mattyicebox/ECE445_Towfish_Magnetometer/CAD_Files/SP26_HookLineandTowfish_AutoDeskInventorFiles_JamesBrasfield/readme.md

M4 heatsink inserts and screws are used for securing the back cap on. M3 screws are used for attaching the PCB to the insert.
