mattyicebox/ECE445_Towfish_Magnetometer/Hardware_Specs/hardware.txt

This file contains the PCB and schematic PDF's from our design.
