mattyicebox/ECE445_Towfish_Magnetometer/(list of files, cad)

Other CAD files:
CAD_Files/AssemblyV1.dwg
CAD_Files/AssemblyV1.iam
CAD_Files/BackCapV1.ipt
CAD_Files/BackCapV2.ipt
CAD_Files/BackInsertV1.ipt
CAD_Files/BackTubeV1.ipt
CAD_Files/BottleV1.ipt
CAD_Files/CoilV1.ipt
CAD_Files/FrontBumper.ipt
CAD_Files/FrontCapV1.ipt
CAD_Files/FrontTubeV1.ipt
CAD_Files/InsertV1.ipt
CAD_Files/OringV1.ipt
CAD_Files/OringV2.ipt
CAD_Files/PCBV1.ipt
