mattyicebox/ECE445_Towfish_Magnetometer/CAD_Files/AssemblyV1.png

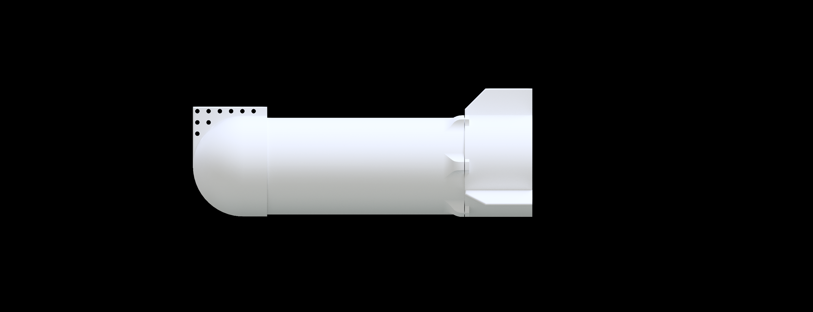
CAD_Files/AssemblyV1.png
