mattyicebox/ECE445_Towfish_Magnetometer/Hardware_Specs/SP26_HookLineandTowfish_description_JamesBrasfieldandBlakeHelland.pdf

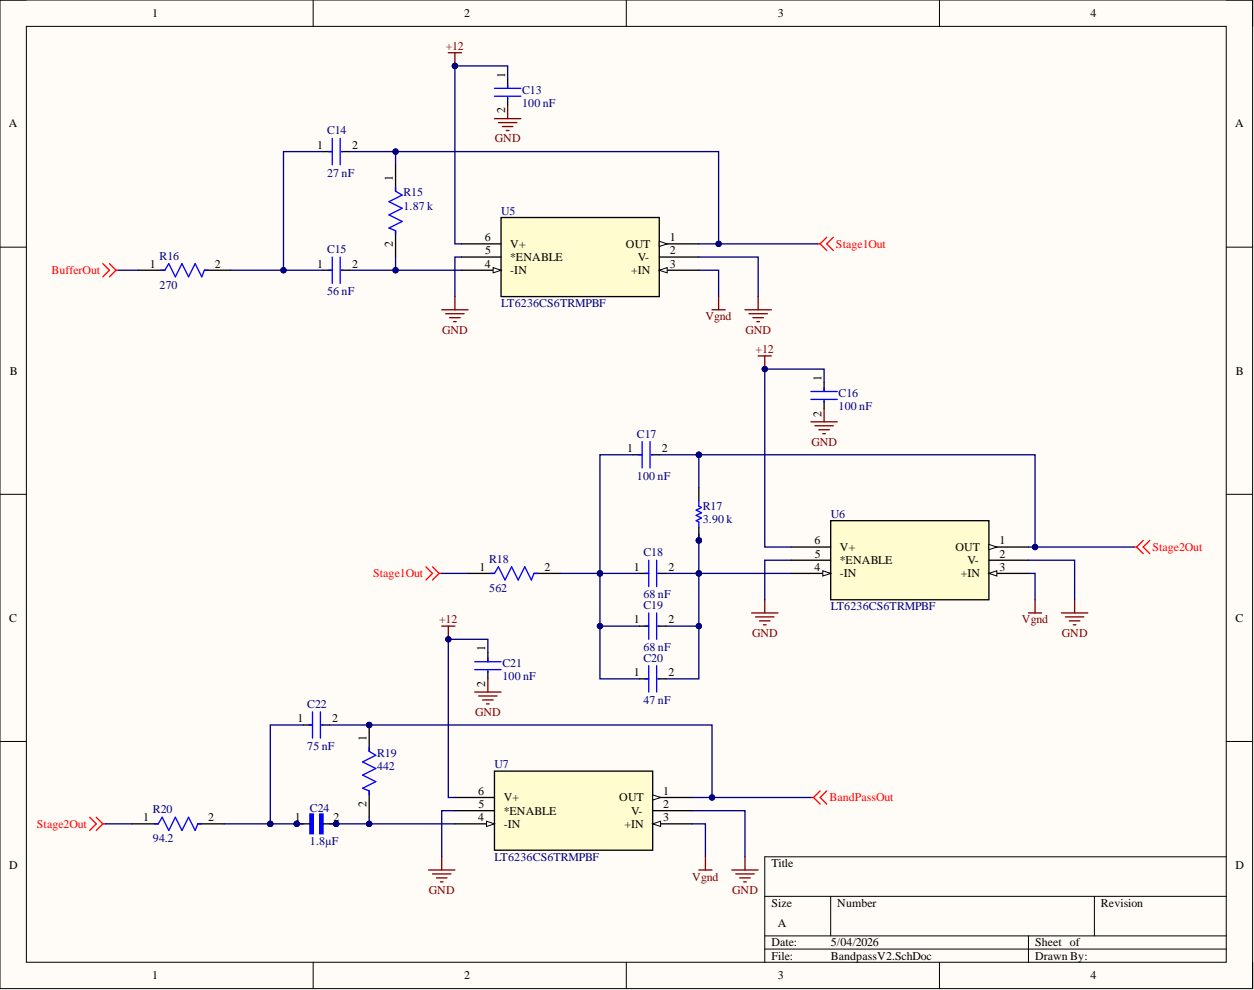
[picture p2: page 1]

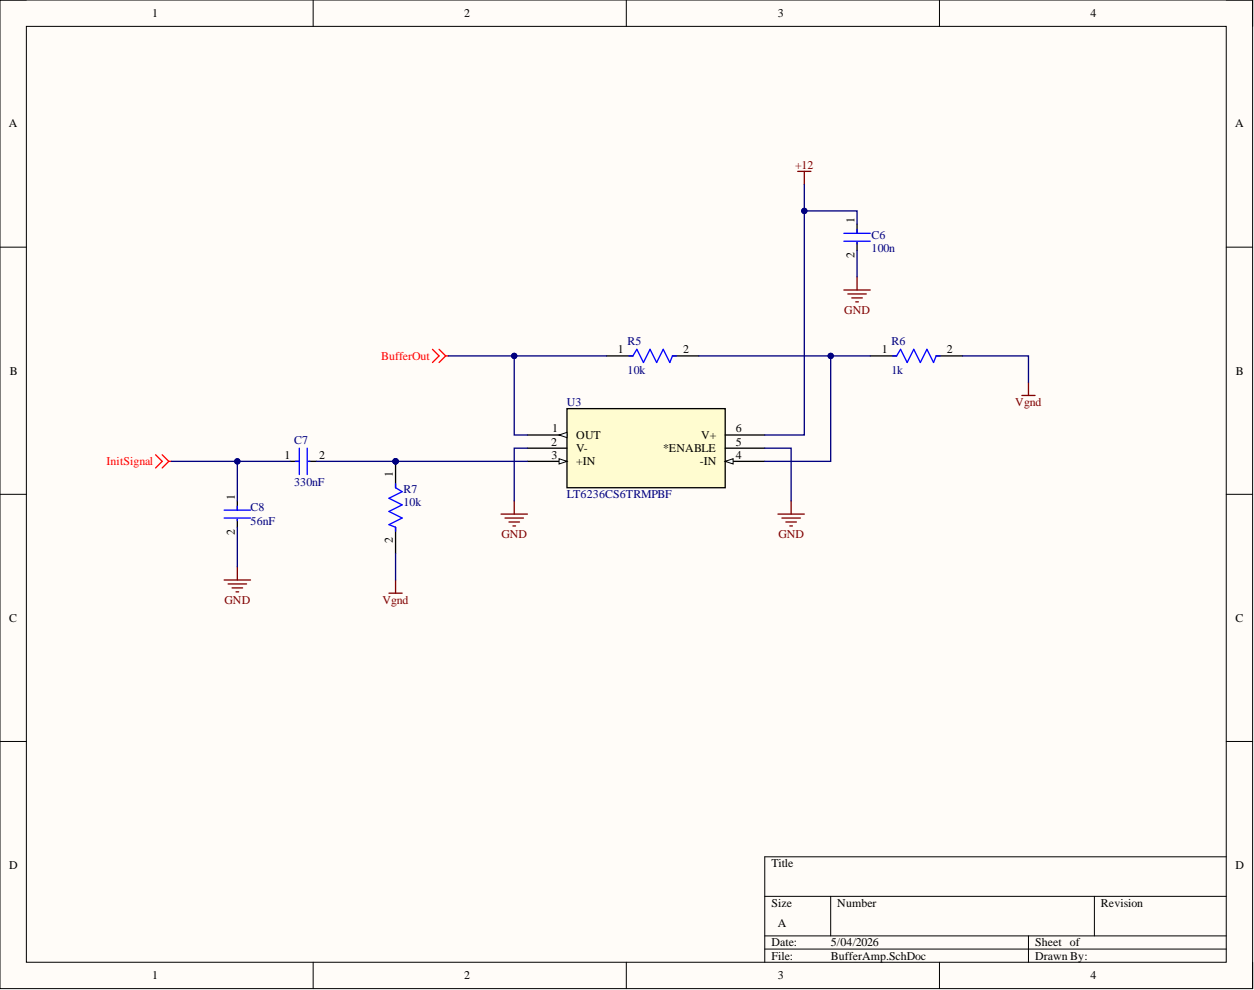
[picture p3: page 2]
File:; BufferAmp.SchDoc; Drawn By:; OUT 1 V- 2; 4 *ENABLE; InitSignal

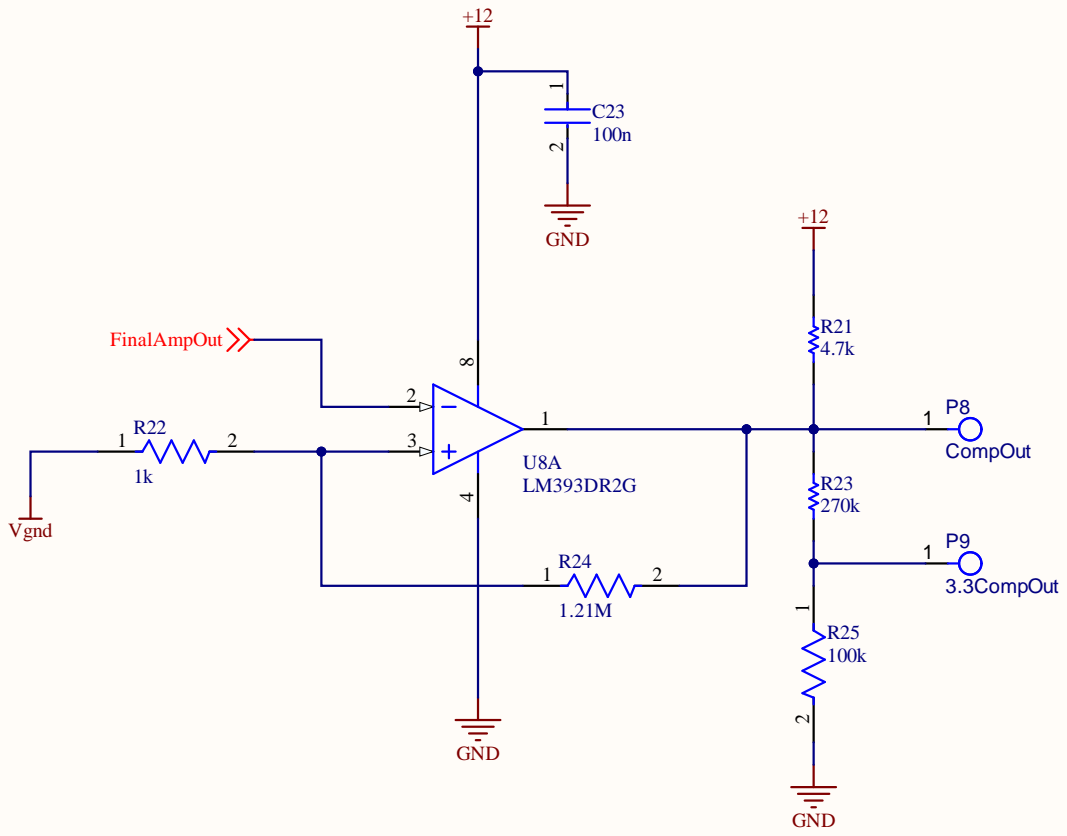
[picture p4: page 3]
1 P8CompO

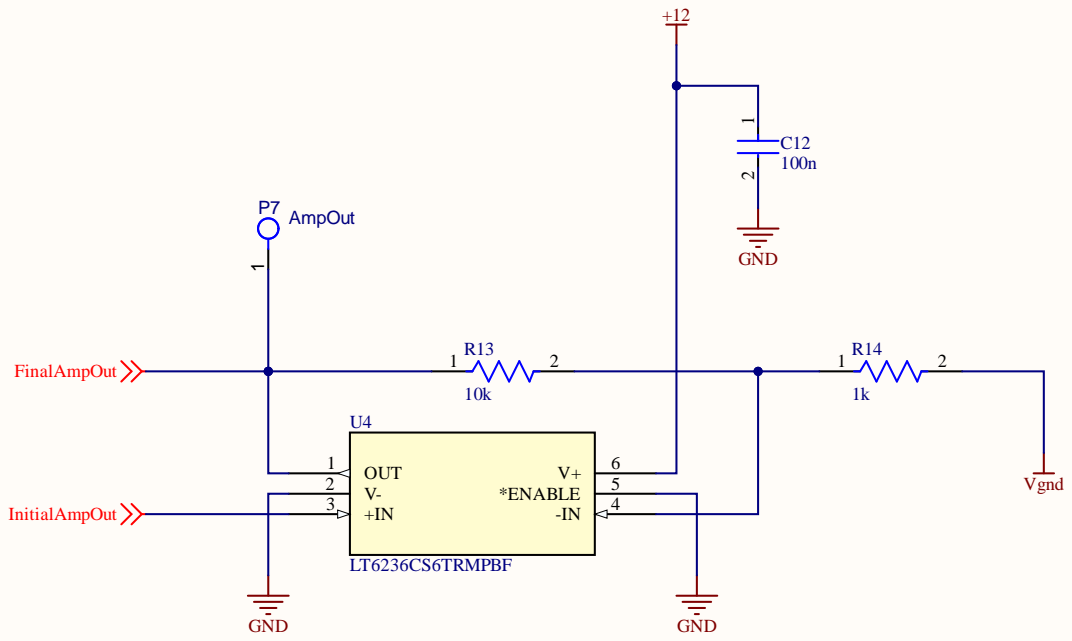
[picture p5: page 4]
File:; FinalAmp.SchDoc; Drawn By:; OUT 1 V- 2; 4 *ENABLE; 1 P7 AmpOut

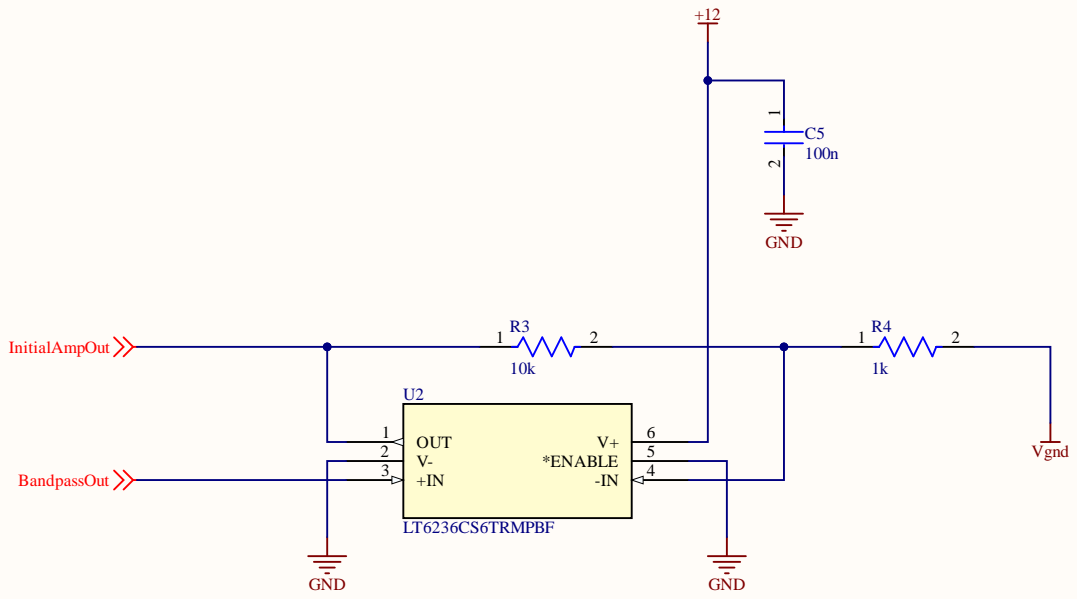
[picture p6: page 5]
File:; InitialAmp.SchDoc; Drawn By:; OUT 1 V- 2; 4 *ENABLE

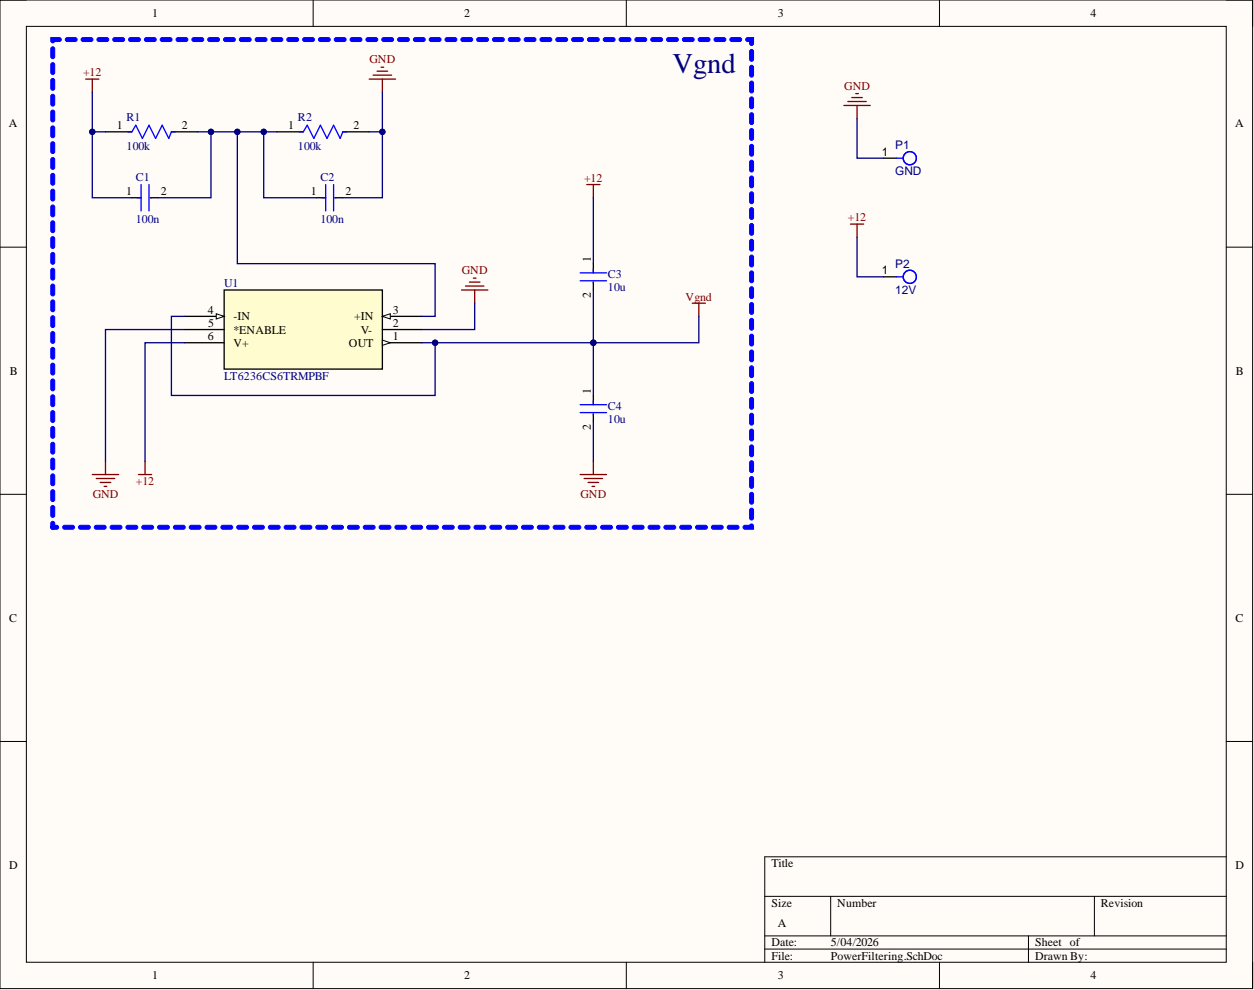
[picture p7: page 6]

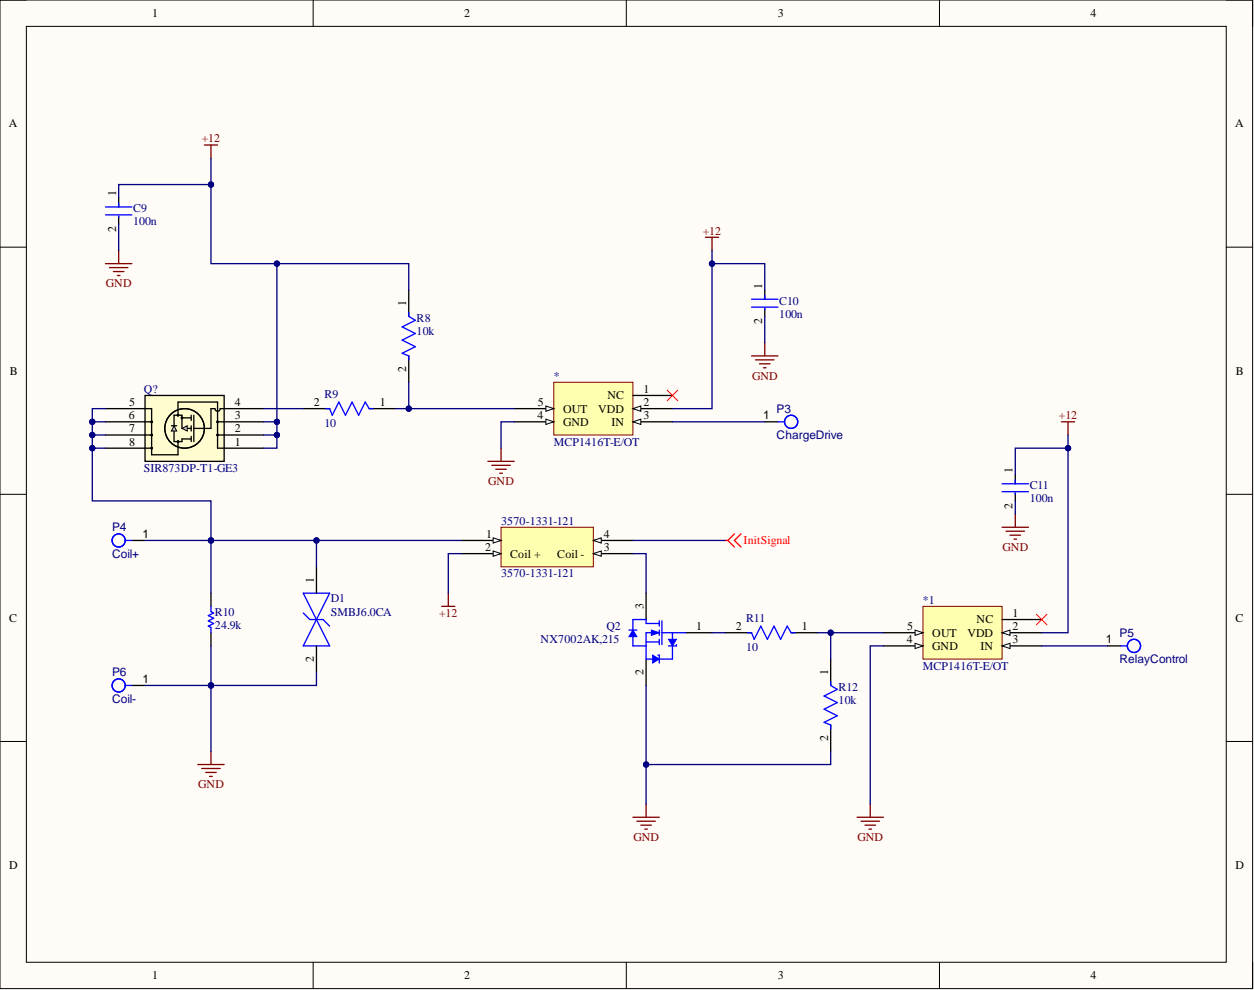
[picture p8: page 7]
