mattyicebox/ECE445_Towfish_Magnetometer/CAD_Files/AssemblyV1.pdf

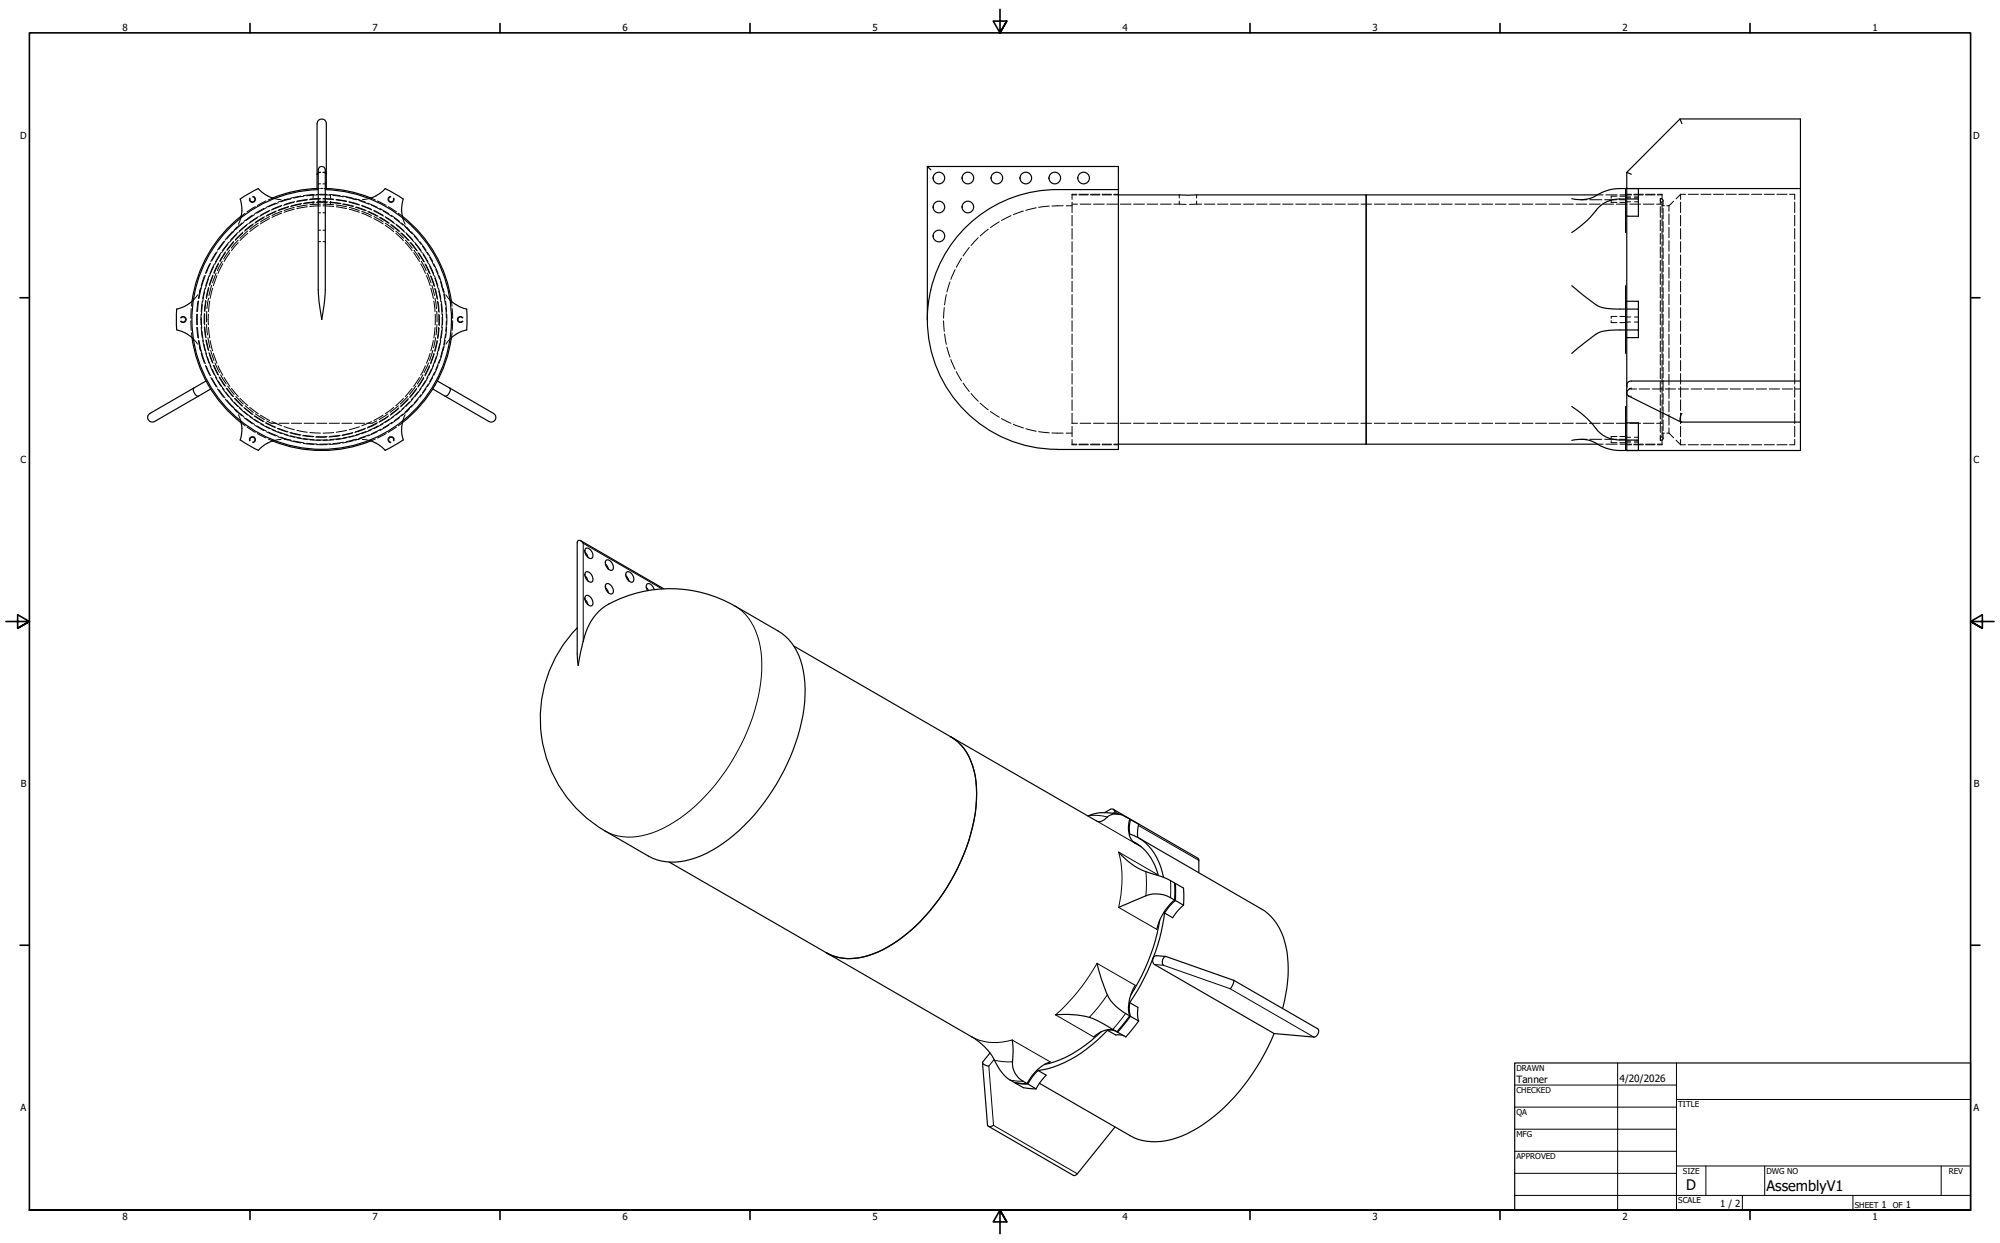
[picture p9: page 1]

DRAWN Tanner | 4/20/2026

CHECKED

MFG

APPROVED

SIZE D | DWG NO AssemblyV1 | REV

SCALE 1 / 2 | | SHEET 1 OF 1
