mattyicebox/ECE445_Towfish_Magnetometer/Simulations/DCOffsetTestV1.asc

C1: cap; 1µ
R1: res; 200
R2: res; 20k
U1: UniversalOpAmp; Avol=100k GBW=10Meg Vos=0
V1: voltage; SINE(0 3u 3k)
V2: voltage; 6
V4: voltage; 12
Named nets: 0, Vout, Vin+6, Vin
.tran 0 0.0005 0 0.000000001
