mattyicebox/ECE445_Towfish_Magnetometer/Simulations/SP26_HookLineandTowfish_BufferOffsetSimulation_JamesBrasfield.asc

C1: cap; 1ľ
C2: cap; 56n
R1: res; 10k
R2: res; 1k
R3: res; 10k
U1: UniversalOpAmp
V1: voltage; 6
V2: voltage; SINE(0 3m 200)
V3: voltage; 6
V4: voltage; 12
Named nets: 0, Vout, Vin+6
.tran 0 0.01 0 0.0000001
