mattyicebox/ECE445_Towfish_Magnetometer/Simulations/SP26_HookLineandTowfish_SwitchingSimulation_JamesBrasfield.asc

D1: zener
D2: zener
L1: ind2; 17m; Rser=9
L2: ind2; 17m; Rser=9
M1: pmos
M2: nmos
M3: nmos
R1: res; 10
R2: res; 10k
R3: res; 10
R4: res; 10k
R5: res; 25k
V1: voltage; 12
V2: voltage; PULSE(12 0 1m 200n 200n 20m 50m)
V3: voltage; 0
Named nets: 0, Inductor, PMOS
.model D D(BV=68 IBV=1m RS=0.2 N=1.2 CJO=200p)
; ===== Gate timing (long charge, long discharge) =====
; V2 drives PMOS gate: OFF = 12V, ON = 0V
; ON from 1ms to 21ms (20ms charge window), then OFF
V2 GP 0 PULSE(12 0 1m 200n 200n 20m 50m)
 
; V3 drives NMOS gate: keep NMOS OFF the whole time (0V)
V3 GN 0 0
; ===== Generic MOSFET models (minimal + stable) =====
.model NMOS NMOS (VTO=3 KP=20 RD=0.02 RS=0.02 CGS=1n CGD=200p)
.model PMOS PMOS (VTO=-3 KP=10 RD=0.05 RS=0.05 CGS=1n CGD=200p)
 
; ===== Transient simulation command =====
.tran 0 60m 0 100n
.model D D(BV=90 IBV=1m RS=0.2 N=1.2 CJO=200p)
