mattyicebox/ECE445_Towfish_Magnetometer/(commit log)

2026-05-04 Rename Schematic PDF_[No Variations].pdf to SP26_HookLineandTowfish_description_JamesBrasfieldandBlakeHelland.pdf
2026-05-06 CAD Files
    [SP26_HookLineandTowfish_CoilHolder_MattSchutt.scad, SP26_HookLineandTowfish_KeroseneHolder_MattSchutt.scad, SP26_HookLineandTowfish_RenderofCoils_MattSchutt.scad, hollow_box_8x8x10cm_top_hole.scad, hollow_square_ring_10cm.scad]
